colbyjohnson1994/FordSeatController/Firmware/FordSeatController/README.md

# FordSeatController
Universal seat controller using Gentex switch on 2018 Ford Taurs Seats.
