colbyjohnson1994/FordSeatController/2018 Ford Taurus Climate Controlled Schematics.docx

Drivers Seat

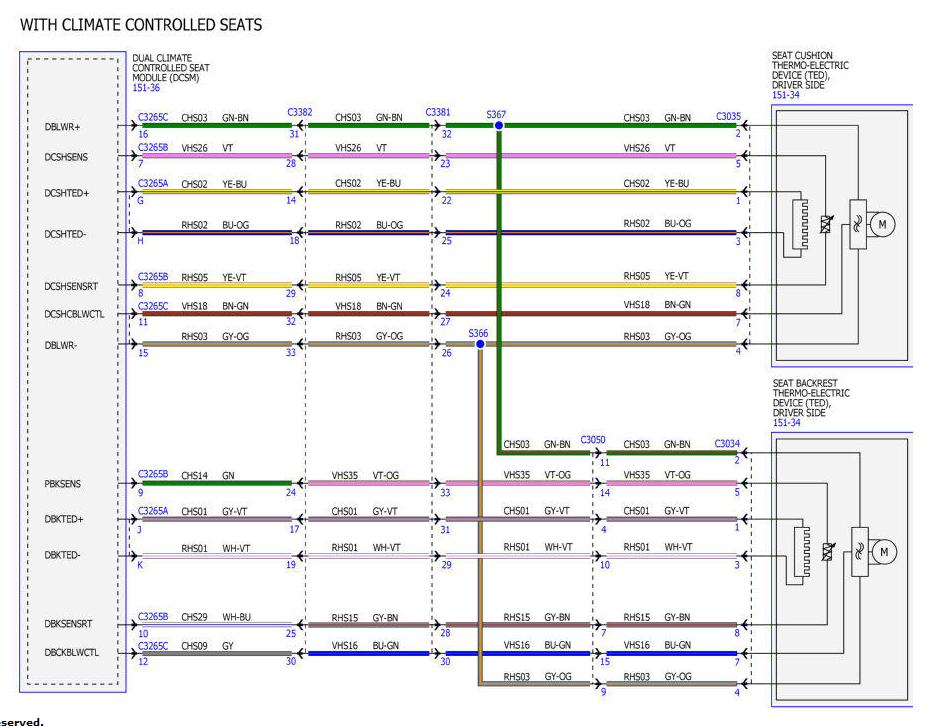
[picture p1: figure]

Passenger Seat

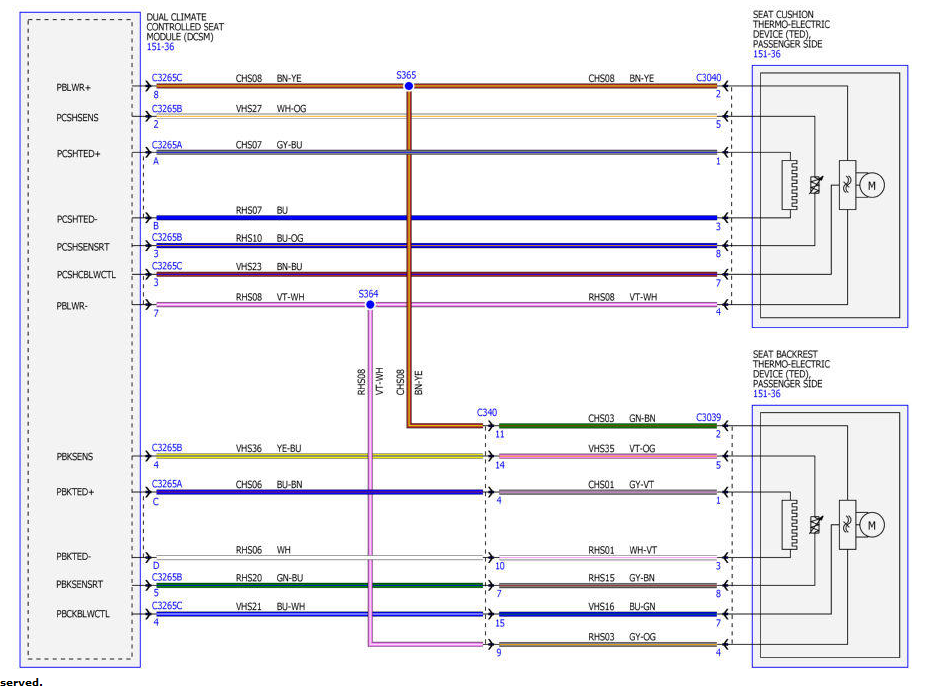
[picture p2: figure]
