colbyjohnson1994/FordSeatController/Controller Specifications.docx

# 2018 Ford Taurus Heated/Cooled Seat Controller Specifications

# Factory Ford Taurus Controller Specifications

Typical heated seat element is between 1-10 ohms (25W max)
