colbyjohnson1994/FordSeatController/Old Hardware/2018 Ford Taurus Climate Controlled Schematics.docx

Drivers Seat


Passenger Seat
