colbyjohnson1994/FordSeatController/v4.0 Hardware/BOM_Seat-Controller_2026-01-24.csv

ID | Name | Designator | Footprint | Quantity | Manufacturer Part | Manufacturer | Supplier | Supplier Part | Price
1 | 10K | R9,R10,R11,R12,R3,R6 | R0805 | 6 | 8-1614884-4 | TE Connectivity | LCSC | C306291 | 0.318
2 | 100Ω | R13,R14,R15,R16 | R0805 | 4 | 0805W8F1000T5E | UNI-ROYAL(厚声) | LCSC | C17408 | 0.002
3 | 10Ω | R17,R18,R19,R20 | R0805_NEW | 4 | 0805W8F100JT5E | UNI-ROYAL(厚声) | LCSC | C17415 | 0.002
4 | MIC4416YM4-TR | U5,U6 | SOT-143-4_L2.9-W1.3-P1.92-LS2.3-BR | 2 | MIC4416YM4-TR | MICROCHIP(美国微芯) | LCSC | C515508 | 0.97
5 | MIC4417YM4-TR | U7,U8 | SOT-143-4_L2.9-W1.3-P1.92-LS2.3-BR | 2 | MIC4417YM4-TR | MICROCHIP(美国微芯) | LCSC | C625793 | 1.469
6 | 100uF | C12 | CAP-SMD_BD6.3-L6.6-W6.6-LS7.6-RD | 1 | RVT1H101M0607 | ROQANG(容强) | LCSC | C3151829 | 0.06
7 | 4-PIN 14AWG | HDR1 | 4-PIN 14AWG | 1 |  |  |  | C66690 | 0.024
8 | 12-PIN 14AWG | HDR2 | 16-PIN 14AWG | 1 |  |  |  | C66690 | 0.024
9 | IPD90N04S4-05 | Q1,Q2 | PG-TO252-3_L6.3-W6.5-P4.57-LS10.0-BR-CW | 2 | IPD90N04S4-05 | Infineon(英飞凌) | LCSC | C536902 | 0.941
10 | HF115F/012-2ZS4 | K1,K2 | RELAY-TH_HF115F-024-2ZS4 | 2 | HF115F/012-2ZS4 | HF(宏发) | LCSC | C163534 | 2.227
11 | 43K | R4,R5 | 0805 | 2 | ERJPB6B4302V | PANASONIC | LCSC | C413702 | 0.101
12 | 43k | R7,R8 | 0805 | 2 | ERJPB6B4302V | PANASONIC | LCSC | C413702 | 0.101
13 | 100nF | C2,C4,C6,C8,C9,C10,C11 | C0603 | 7 | C0603X104K101T | IHHEC(禾伸堂) | LCSC | C105907 | 0.006
14 | LM2940S-5.0 | U4 | SOT-223-3_L6.5-W3.4-P2.30-LS7.0-BR | 1 | LM2940S-5.0 | HTC | LCSC | C596334 | 0.473
15 | 470nF | C1,C5 | CAP-SMD_L3.2-W1.6 | 2 | TC211A474M035Y | Sunlord | LCSC | C128328
16 | 10uF | C3,C7 | C1206 | 2 | CL31B106KOHNNNE | SAMSUNG(三星) | LCSC | C47971 | 0.034
17 | 0430451000 | CONN3 | CONN-TH_43045-1000 | 1 | 0430451000 | MOLEX
18 | SMAJ6.0A-AT | D2 | SMA_L4.3-W2.6-LS5.1-R-RD | 1 | SMAJ6.0A-AT | Brightking(君耀电子) | LCSC | C523250 | 0.056
19 | MMBZ5226BLT1G | D3,D4 | SOT-23_L2.9-W1.3-P1.90-LS2.4-BR | 2 | MMBZ5226BLT1G | ON | LCSC | C94380 | 0.04
20 | 3522-2 | F1,F2 | FUS_AUTO_KEYSTONE_3522-2 | 2 | 3522-2 |  | Digi-Key | 36-3522-2-ND
21 | IRFR9024NTRPBF | Q3,Q6 | TO-252-2_L6.6-W6.1-P4.58-LS9.9-TR | 2 | IRFR9024NTRPBF | Infineon(英飞凌) | LCSC | C2585 | 0.226
22 | 240 | R1 | R0805 | 1 | AC0805FR-07240RL | YAGEO | LCSC | C228652 | 0.005
23 | 1.5K | R2 | 0805 | 1 | RMC08051.5K1%N | Tyohm | LCSC | C269739 | 0.005
24 | ItsyBitsy M0 Express | U1 | ITSYBITSY | 1 |  |  | Adafruit | 3727
25 | LM317MG-AA3-R | U2 | SOT-223-3_L6.5-W3.4-P2.30-LS7.0-BR | 1 | LM317MG-AA3-R | Unisonic Tech | LCSC | C427637 | 0.135
26 | ULN2003AID | U3 | SOIC-16_L9.9-W3.9-P1.27-LS6.0-BL | 1 | ULN2003AID | TI(德州仪器) | LCSC | C354530 | 0.392
