colbyjohnson1994/FordSeatController/BOM_PCB_Seat Controller_2023-02-26.csv

ID | Name | Designator | Footprint | Quantity | Manufacturer Part | Manufacturer | Supplier | Supplier Part | Price | Pins | 3DModel | Contributor | Resistance | SMT Type | link
1 | 470nF | C1,C5 | CAP-SMD_L3.2-W1.6 | 2 | TC211A474M035Y | Sunlord | LCSC | C128328 | 0.018 | 2 | CAP-SMD_L3.2-W1.6 | LCSC |  | Extend | https://item.szlcsc.com/8491.html
2 | 100nF | C2,C4,C6,C8,C9,C10,C11 | C0603 | 7 | C0603C104K4RAC7867 | KEMET | LCSC | C141082 | 0.003 | 2 | C0603_L1.6-W0.8-H0.8 | LCSC |  |  | https://item.szlcsc.com/362304.html
3 | 10uF | C3,C7 | C1206 | 2 | CL31B106KOHNNNE | SAMSUNG(三星) | LCSC | C47971 | 0.003 | 2 | C1206_L3.2-W1.6-H1.3 | lcsc |  |  | https://item.szlcsc.com/89171.html
4 | 43045-0400 | CONN1 | CONN-TH_43045-0400 | 1 | 43045-0400 | MOLEX | LCSC | C189222 |  | 4 | CONN-TH_43045-0400 | LCSC |  |  | https://atta.szlcsc.com/upload/public/pdf/source/20181015/C189222_6BA82FD29DF20D5F705929E769277364.pdf
5 | HEADER_POS12_?43045-1200 | CONN2 | 43045-1200 | 1 |  |  |  |  |  | 12 | 43045-1200 | Jacopo Franco
6 | 0430451000 | CONN3 | CONN-TH_43045-1000 | 1 | 0430451000 | MOLEX | LCSC | C122421 | 0.091 | 10 | CONN-TH_43045-1000 | 立创EDA官方封装库 |  |  | https://item.szlcsc.com/123690.html
7 | MMBZ5237BLT1G | D1,D5 | SOT-23-3_L2.9-W1.3-P1.90-LS2.4-BR | 2 | MMBZ5237BLT1G | ON Semicon | LCSC | C235759 | 0.008 | 3 | SOT-23-3P_L2.9-W1.3-H1.0-LS2.4-P0.95 | LCSC |  |  | https://www.diodes.com/assets/Package-Files/SOT23.pdf
8 | SMAJ6.0A-AT | D2 | SMA_L4.3-W2.6-LS5.1-R-RD | 1 | SMAJ6.0A-AT | Brightking(君耀电子) | LCSC | C523250 | 0.01 | 2 | SMA_L4.3-W2.6-LS5.1-R-RD | LCSC |  |  | https://atta.szlcsc.com/upload/public/pdf/source/20200107/C478604_04F79D72F1741FAE86809CB7AAE2DD89.pdf
9 | MMBZ5226BLT1G | D3,D4 | SOT-23_L2.9-W1.3-P1.90-LS2.4-BR | 2 | MMBZ5226BLT1G | ON | LCSC | C94380 | 0.006 | 3 | SOT-23-3P_L2.9-W1.3-H1.0-LS2.4-P0.95 | 官方封装库 |  |  | https://item.szlcsc.com/236142.html
10 | 3522-2 | F1,F2 | FUS_AUTO_KEYSTONE_3522-2 | 2 | 3522-2 |  | Digi-Key | 36-3522-2-ND |  | 4 | keystone-pn3522-2 | chrisaliotta |  |  | http://www.keyelco.com/product-pdf.cfm?p=1373
11 | HDR-F-2.54_1x4 | H1 | HDR-F-2.54_1X4 | 1 |  |  | LCSC | C225501 | 0.013 | 4 | HDR-F-2.54_1x4 | LCEDA_Lib
12 | IRFR9024NTRPBF | Q1,Q3,Q6,Q7 | TO-252-2_L6.6-W6.1-P4.58-LS9.9-TR | 4 | IRFR9024NTRPBF | Infineon(英飞凌) | LCSC | C2585 | 0.052 | 3 | TO-252-2_L6.6-W6.1-P4.58-LS9.9-TR | LCSC |  |  | https://atta.szlcsc.com/upload/public/pdf/source/20140818/1457707226056.pdf
13 | KTC8050S-C-RTK/P | Q2,Q4,Q5,Q8 | SOT-23-3_L2.9-W1.3-P1.90-LS2.4-BL | 4 | KTC8050S-C-RTK/P | KEC Semicon | LCSC | C220523 | 0.004 | 3 | SOT-23-3P_L2.9-W1.3-H1.0-LS2.4-P0.95 | LCSC |  |  | https://item.szlcsc.com/221067.html
14 | 240 | R1 | R0805 | 1 | AC0805FR-07240RL | YAGEO | LCSC | C228652 | 0.001 | 2 | R0805_L2.0-W1.3-H0.6 | LCSC |  |  | https://item.szlcsc.com/142685.html
15 | 1K | R3,R6 | R0805 | 2 | 8-1614884-4 | TE Connectivity | LCSC | C306291 | 0.046 | 2 | R0805_L2.0-W1.3-H0.6 | LCSC |  |  | https://item.szlcsc.com/142685.html
16 | 1.5K | R2 | 0805 | 1 | RMC08051.5K1%N | Tyohm | LCSC | C269739 | 0.001 | 2 | R0805 | LCSC
17 | 10K | R4,R5,R7,R8 | 0805 | 4 | ERJPB6B4302V | PANASONIC | LCSC | C413702 | 0.014 | 2 | R0805 | SparkFun |  |  | https://lcsc.com/product-detail/Chip-Resistor-Surface-Mount_PANASONIC-ERJPB6B4302V_C413702.html
18 | 1K | RN1,RN2 | RES-ARRAY-SMD_0603-8P-L3.2-W1.6-BL | 2 | YC164-JR-071KL | YAGEO(国巨) | LCSC | C93675 | 0.001 | 8 | R0603-8P_L3.2-W1.6-H0.6 | LCSC | 1kΩ |  | https://item.szlcsc.com/20907.html
19 | ItsyBitsy M0 Express | U1 | ITSYBITSY | 1 |  |  | Adafruit | 3727 |  | 33 | itsybitsym0express_headers | DenverRick
20 | LM317MG-AA3-R | U2 | SOT-223-3_L6.5-W3.4-P2.30-LS7.0-BR | 1 | LM317MG-AA3-R | Unisonic Tech | LCSC | C427637 | 0.023 | 4 | SOT-223-4P_L6.5-W3.5-H1.6-LS7.0-P2.30 | LCSC |  |  | https://item.szlcsc.com/410724.html
21 | ULN2003AID | U3 | SOIC-16_L9.9-W3.9-P1.27-LS6.0-BL | 1 | ULN2003AID | TI(德州仪器) | LCSC | C354530 | 0.29 | 16 | SOIC-16_L9.9-W3.9-H1.8-LS6.0-P1.27 | LCSC |  |  | http://datasheet.octopart.com/MC14076BDR2G-ON-Semiconductor-datasheet-608107.pdf
22 | LM2940HS-3.3 | U4 | SOT-223-3_L6.5-W3.4-P2.30-LS7.0-BR | 1 | LM2940HS-3.3 | HTC | LCSC | C784715 | 0.134 | 4 | SOT-223-4P_L6.5-W3.5-H1.6-LS7.0-P2.30 | LCSC |  |  | https://item.szlcsc.com/410724.html
