colbyjohnson1994/FordSeatController/CAD Files/BottomHalf.stl

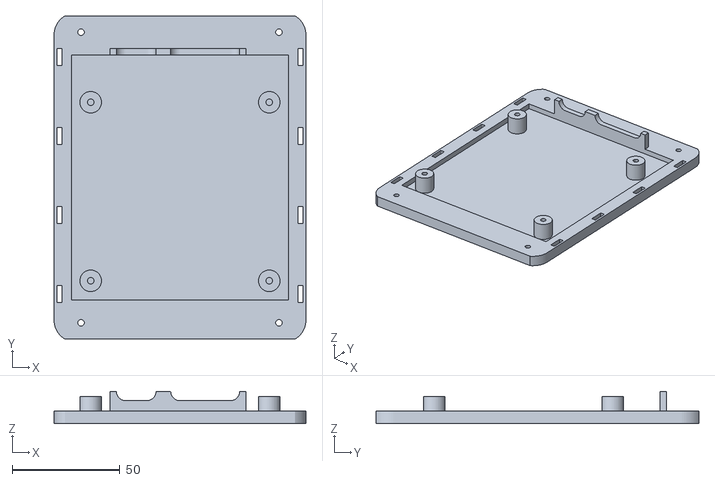
[picture p3: CAD file, 2026-01-26]
CAD Files/BottomHalf.stl
116.8 x 149.8 x 15.0
