colbyjohnson1994/FordSeatController/v4.0 Hardware/PCB_Seat-Controller_2026-01-24.dxf

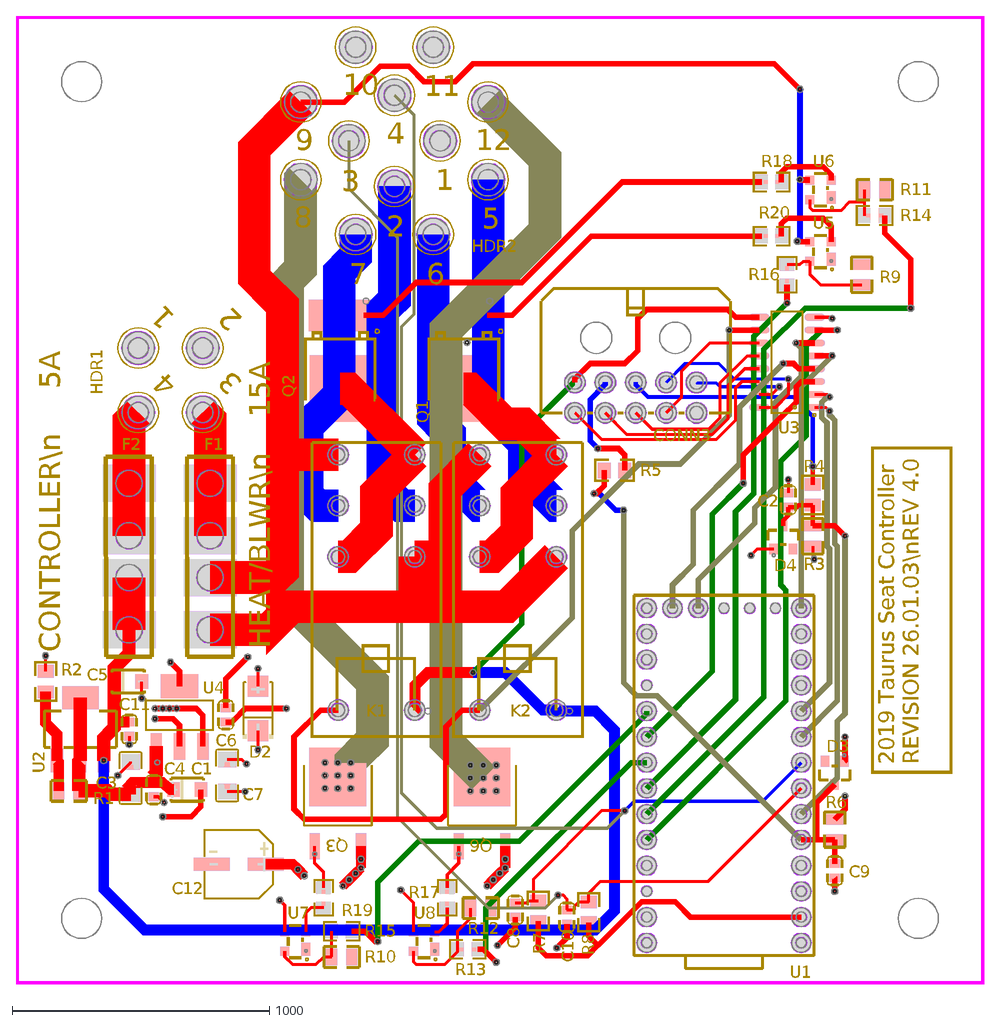
[picture p4: CAD file, 2026-01-24]
v4.0 Hardware/PCB_Seat-Controller_2026-01-24.dxf
HEAT/BLWR\n 15A
CONTROLLER\n 5A
REVISION 26.01.03\nREV 4.0
2019 Taurus Seat Controller
R9
R10
R11
R12
R13
R14
R15
R16
R17
R18
R19
R20
U5
U6
U7
U8
C12
HDR1
1
2
3
4
HDR2
5
6
7
8
9
10
11
12
Q1
Q2
R3
R6
K1
K2
R4
R5
R7
R8
C2
C4
C6
C8
C9
C10
C11
U4
C1
C5
C3
C7
CONN3
D2
D3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
