colbyjohnson1994/FordSeatController/CAD Files/TopHalf.stl

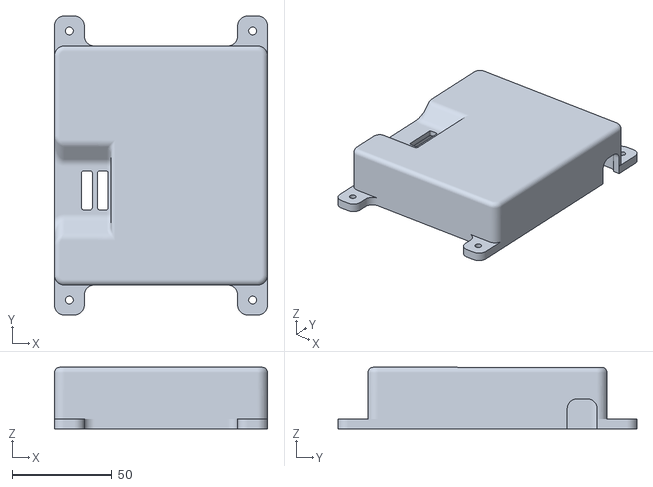
[picture p5: CAD file, 2026-01-26]
CAD Files/TopHalf.stl
106.8 x 149.8 x 30.8
