colbyjohnson1994/FordSeatController/CAD Files/c-dt04-4p-a-3d.stp

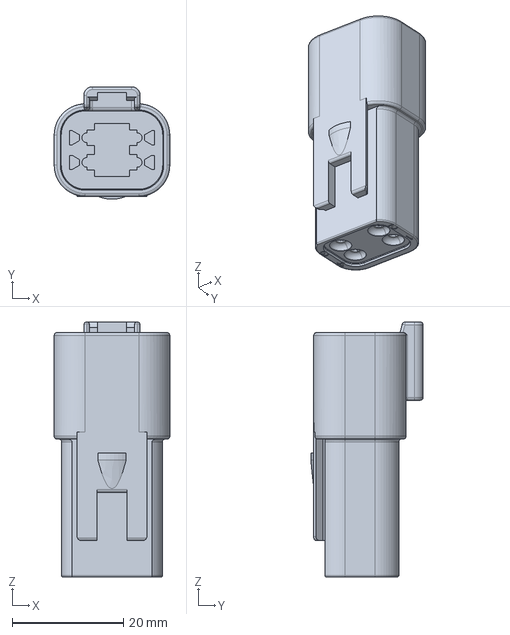
[picture p6: CAD file, 2026-01-26]
CAD Files/c-dt04-4p-a-3d.stp
20.8 x 20.2 x 45.9 mm
