colbyjohnson1994/FordSeatController/CAD Files/ATC 15A.SLDPRT

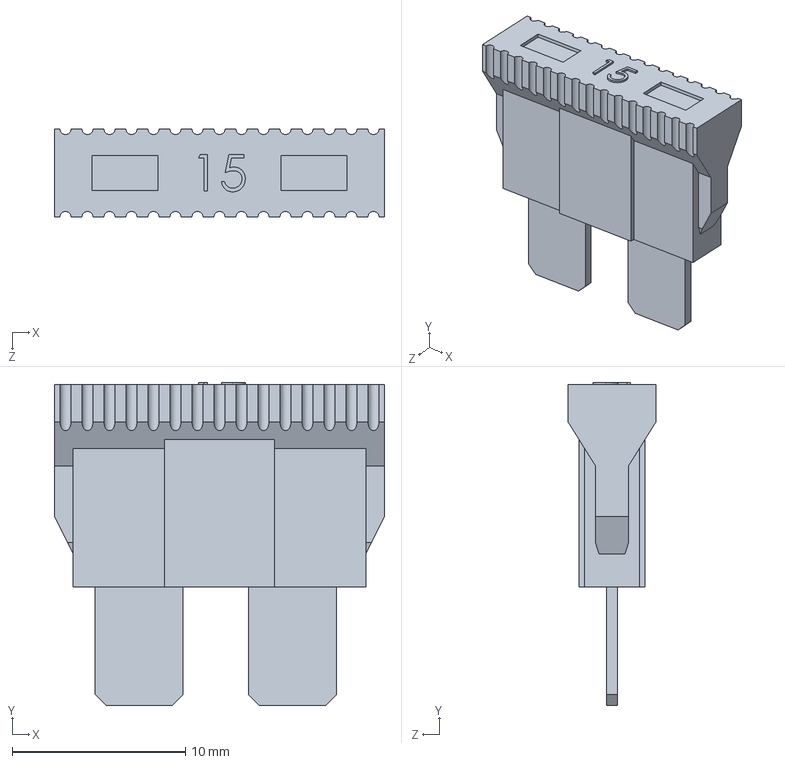
[picture p7: CAD file, 2026-01-26]
CAD Files/ATC 15A.SLDPRT
19.1 x 18.7 x 5.08 mm
