colbyjohnson1994/FordSeatController/CAD Files/c-dt04-12pa-c015-f-3d.stp

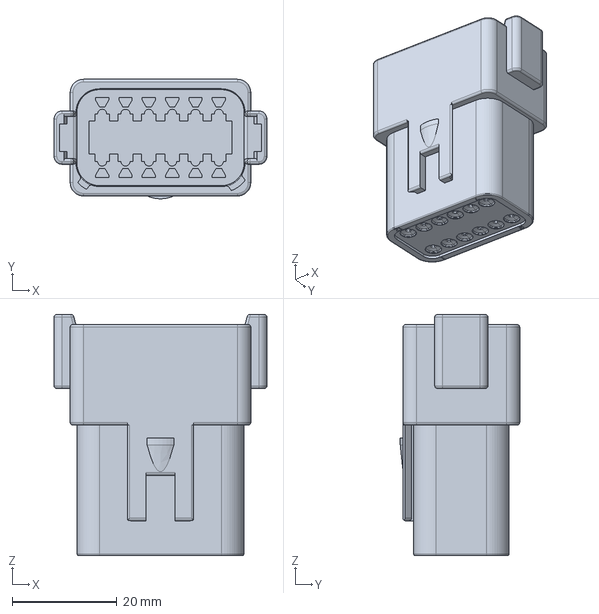
[picture p8: CAD file, 2026-01-26]
CAD Files/c-dt04-12pa-c015-f-3d.stp
40.6 x 22.8 x 45.9 mm
