colbyjohnson1994/FordSeatController/CAD Files/ATC 5A.stp

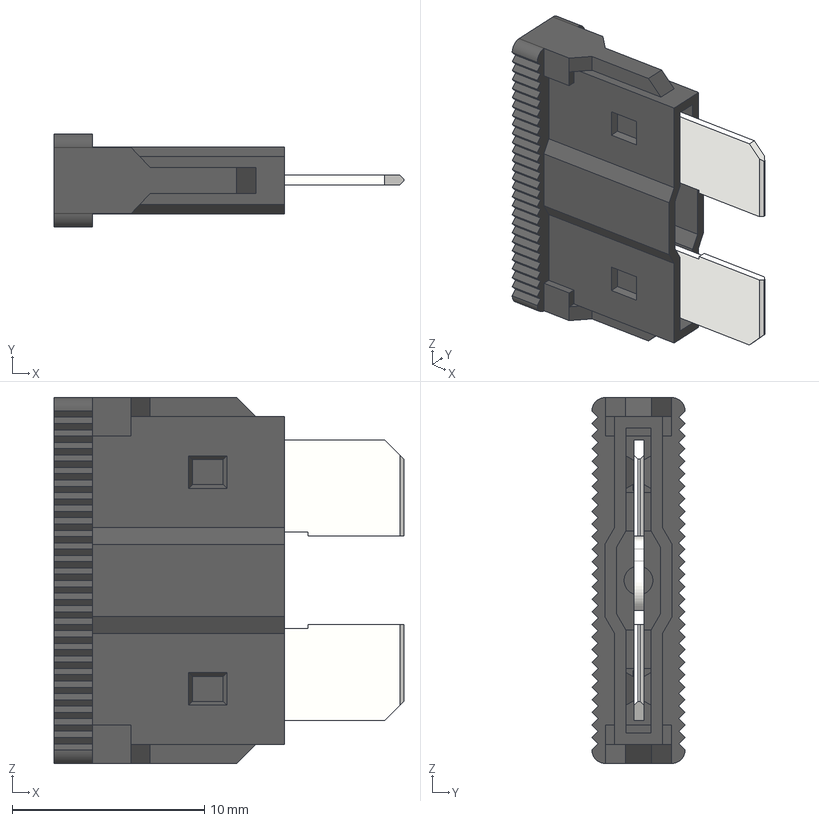
[picture p9: CAD file, 2026-01-26]
CAD Files/ATC 5A.stp
18.2 x 4.85 x 19.1 mm
Fuse
Fuse2
