colbyjohnson1994/FordSeatController/v4.0 Hardware/Schematic_Seat-Controller_2026-01-24.pdf

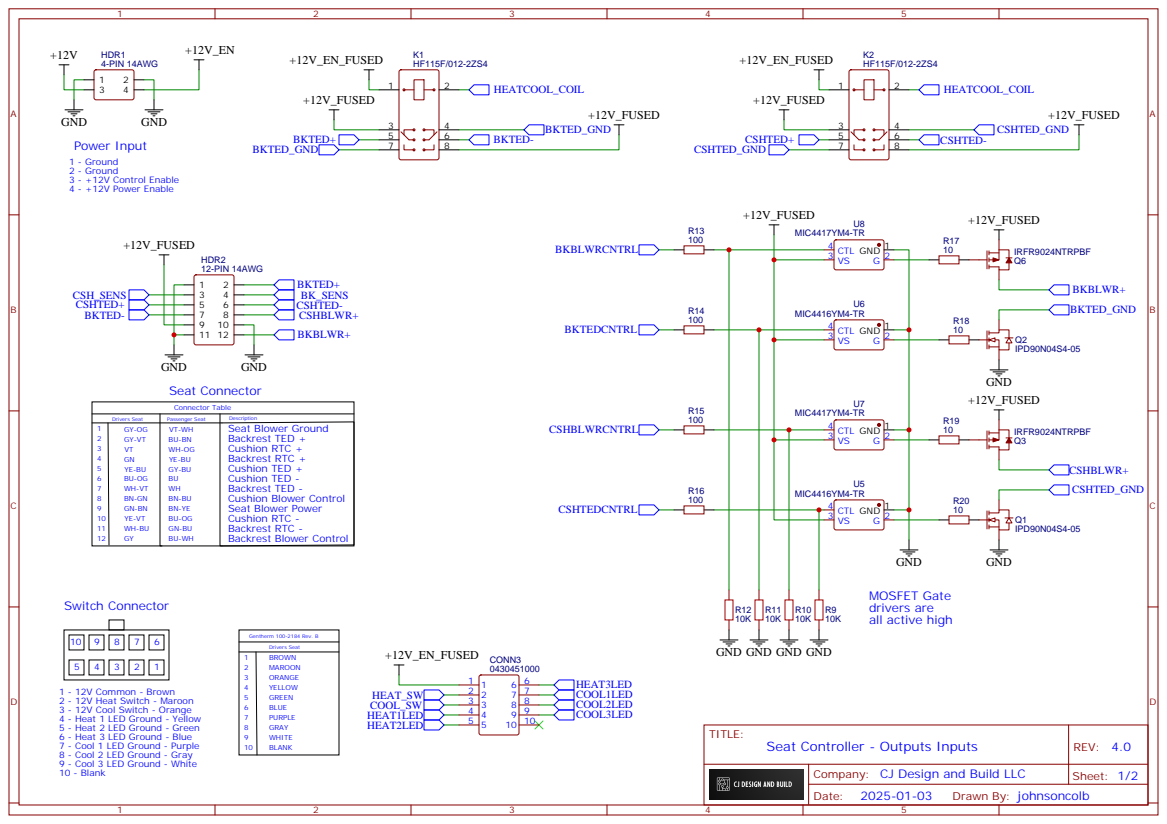
[picture p10: page 1]

1 - 12V Common - Brown
2 - 12V Heat Switch - Maroon
3 - 12V Cool Switch - Orange
4 - Heat 1 LED Ground - Yellow
5 - Heat 2 LED Ground - Green
6 - Heat 3 LED Ground - Blue
7 - Cool 1 LED Ground - Purple
8 - Cool 2 LED Ground - Gray
9 - Cool 3 LED Ground - White
10 - Blank

Company: CJ Design and Build LLC

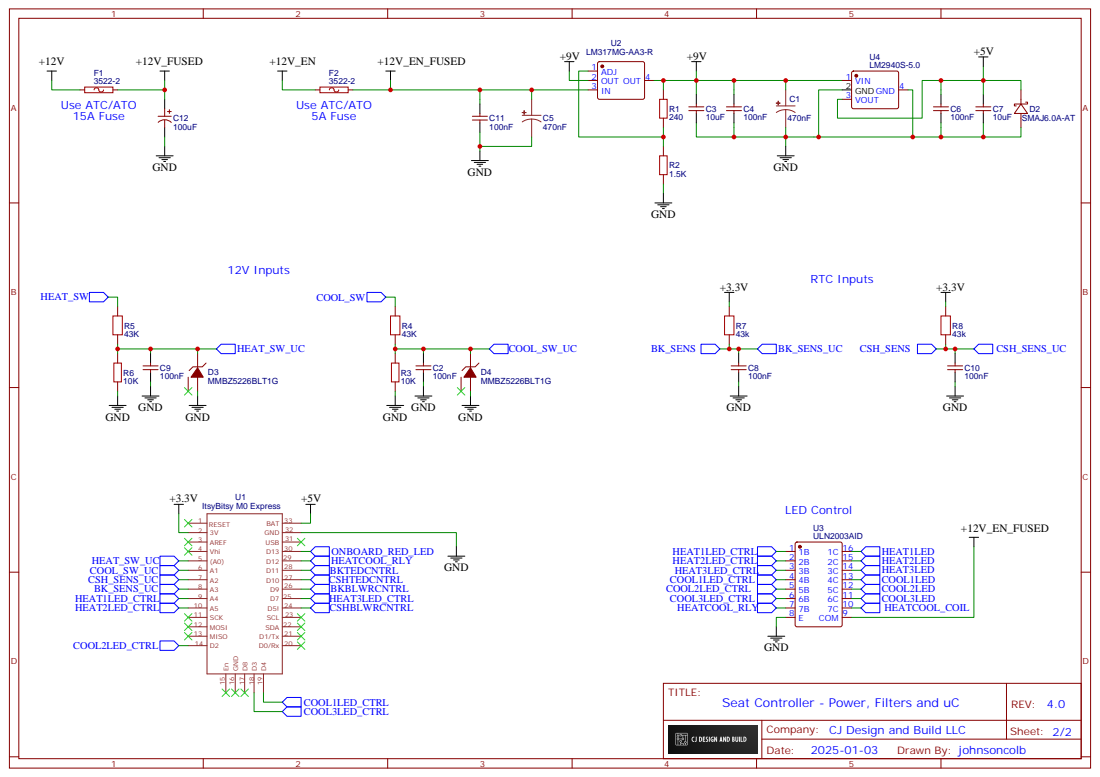
[picture p11: page 2]

Company: CJ Design and Build LLC
