colbyjohnson1994/FordSeatController/Firmware/FordSeatController/firmware/SeatController/SeatController.ino

#include "includes.h"

void setup() {
  //initialize serial
  Serial.begin(115200);

  delay(1000);

  // initialize DotStar LED
  _DotStarLED.begin();  // Initialize pins for output
  _DotStarLED.setBrightness(80);
  _DotStarLED.show();  // Turn all LEDs off ASAP

  initializeInputs();
  initializeDigitalOutputs();
  initializeAnalogOutputs();

  // initialize counting variables
  _sensor_seconds = millis();
  _control_seconds = millis();
  _software_seconds = millis();
  _button_seconds = millis();
  _pwm_seconds = millis();

  Serial.println("Controller Initialized");
  Serial.println("Firmware Revision: 01.23.2026");
  Serial.println("CJ Design and Build\r\n");

  //turn the PID on
  cshPID.SetMode(AUTOMATIC);
  bkPID.SetMode(AUTOMATIC);
  cshFanPID.SetMode(AUTOMATIC);
  bkFanPID.SetMode(AUTOMATIC);

  // Enable SAMD21 watchdog - 4 second timeout
  wdt_init ( WDT_CONFIG_PER_1K );
}

void loop() {
  wdt_reset ( );

  CoolBtn.update();
  HeatBtn.update();

  if ((millis() - _cooldown_seconds) > COOLDOWN_TIMER) {
    if (COOLDOWN_ACTIVE)
      COOLDOWN_ACTIVE = false;
  }

  if ((millis() - _pwm_seconds) > PWM_INTERVAL) {
    // pwm interval has elapsed
    _pwm_seconds = millis();

    UpdatePWMOutputs();
  }

  if ((millis() - _button_seconds) > BUTTON_FREQ) {
    // buttons frequency has elapsed, read from buttons
    _button_seconds = millis();

    CheckButtons();
    SetLEDOutputs();
  }

  if ((millis() - _sensor_seconds) > READ_FREQ) {
    // read frequency has elapsed, read from sensors
    _sensor_seconds = millis();

    ReadFromInputs();

    CheckTemperatureLimits();
  }

  if ((millis() - _control_seconds) > CONTROL_FREQ) {
    _control_seconds = millis();

    AdjustPWMValues();
  }

  if ((millis() - _software_seconds) > SOFTWARE_FREQ) {
    _software_seconds = millis();

    CheckSerialCommands();
    UpdateSoftware();
  }
}
