colbyjohnson1994/FordSeatController/Firmware/FordSeatController/firmware/SeatController/includes.h

#ifndef INCLUDES
#define INCLUDES

#include <Adafruit_DotStar.h>
#include <AverageThermistor.h>
#include <NTC_Thermistor.h>
#include <SmoothThermistor.h>
#include <Thermistor.h>
#include <ResponsiveAnalogRead.h>
#include <wdt_samd21.h>
#include <PID_v1.h>
#include "globals.h"

// NTC THERMISTOR LIBRARY NEEDS TO BE 2.0.1

#endif
