colbyjohnson1994/FordSeatController/(commit log)

2023-03-16 Framework of code being laid out. Starting to put in pin definitions and basic controller functionality
2023-03-30 Framework for all code is written.
    Untested, but should contain all code necessary to provide functionality.
2023-04-26 Converted to using PID library and duty cycle frequency of 100 hz
2023-05-01 Moved the GIT folder location two folders upward to encompass firmware software and all specs
    [BOM_PCB_Seat Controller_2023-02-26.csv, PickAndPlace_PCB_Seat Controller_2023-02-26.csv]
2025-02-17 Correct temperature sensing
    Working on trying to fix overheating issue
    [Helpers.ino, globals.h]
2026-01-24 REV 4.0
    Working firmware and software for rev 4.0. Need to adjust heating and add better cooling and fan logic
2026-01-24 Blower PID
2026-01-24 Fan PID implementation
2026-01-24 Added mechanical documentation
    [BOM_PCB_Seat Controller_2023-02-26.csv, BOM_Seat-Controller_2026-01-24.csv, PCB_Seat-Controller_2026-01-24.dxf, PickAndPlace_PCB_Seat Controller_2023-02-26.csv, PickAndPlace_PCB_Seat-Controller_2026-01-24.csv]
2026-01-25 added 3d exports of pcb
2026-01-25 Reupload of 3d modol. Fixed bug where led's wouldn't update to correct when auto switching modes after 1 hour
    [Helpers.ino]
2026-01-25 Disabled auto switching modes
    Tom probably wouldn't like it
2026-01-26 Added cad files folder and some assets
    [ATC 15A.SLDPRT, ATC 5A.stp, c-dt04-12pa-c015-f-3d.stp, c-dt04-4p-a-3d.stp]
2026-01-26 Mesh files added
    [BottomHalf.stl, TopHalf.stl]
2026-01-26 Updated meshes
    [BottomHalf.stl, TopHalf.stl]
2026-02-14 Updated schematic
